daniel17903/PillDispenser/hardware/stl/mechanism/part_1_servo_horn.stl

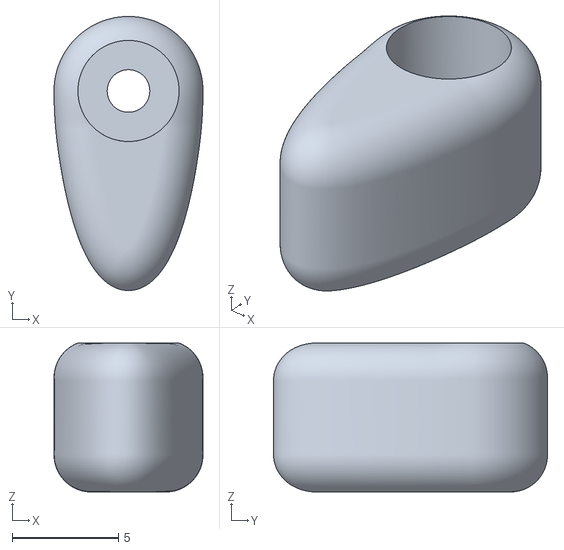
[picture p3: CAD file, 2026-11-14]
hardware/stl/mechanism/part_1_servo_horn.stl
7.00 x 12.9 x 7.00
