daniel17903/PillDispenser/hardware/stl/top.stl

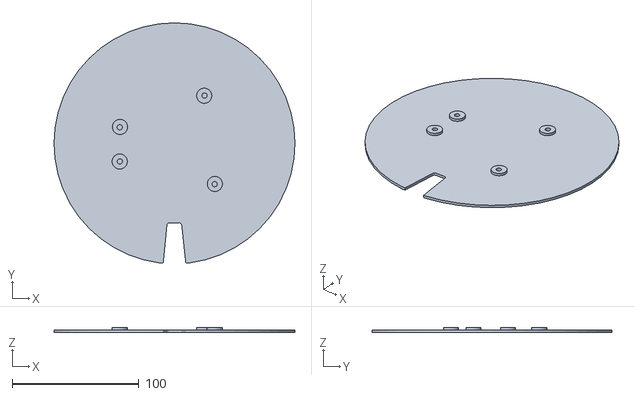
[picture p4: CAD file, 2026-11-07]
hardware/stl/top.stl
190.5 x 189.9 x 4.00
