daniel17903/PillDispenser/hardware/stl/bottom.stl

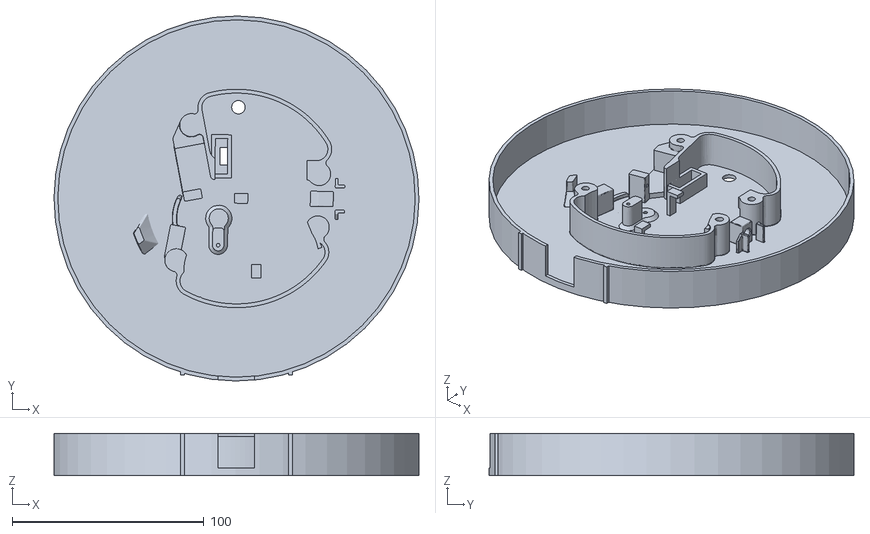
[picture p5: CAD file, 2026-11-07]
hardware/stl/bottom.stl
190.5 x 190.5 x 22.0
