daniel17903/PillDispenser/hardware/stl/mechanism/part_3_pawl.stl

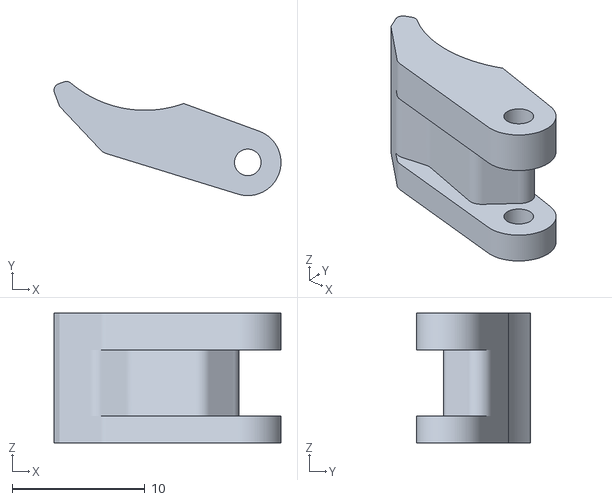
[picture p6: CAD file, 2026-11-07]
hardware/stl/mechanism/part_3_pawl.stl
17.1 x 8.59 x 9.75
