daniel17903/PillDispenser/hardware/stl/foot.stl

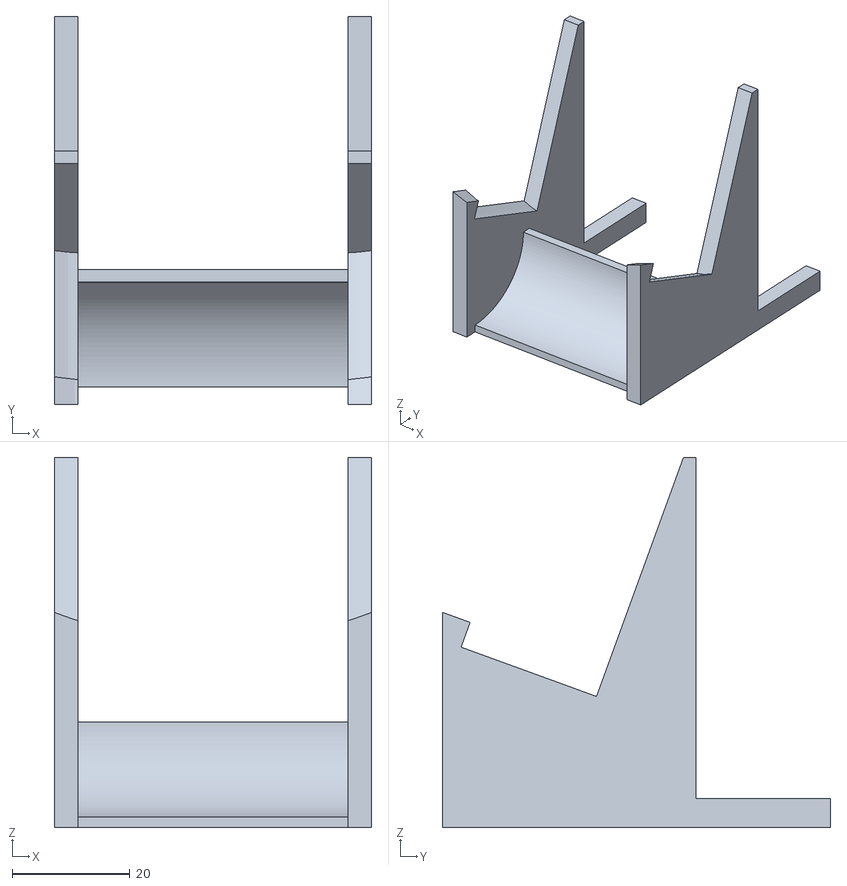
[picture p7: CAD file, 2026-11-07]
hardware/stl/foot.stl
54.0 x 66.0 x 63.0
