daniel17903/PillDispenser/hardware/stl/mechanism/part_4_detent_block.stl

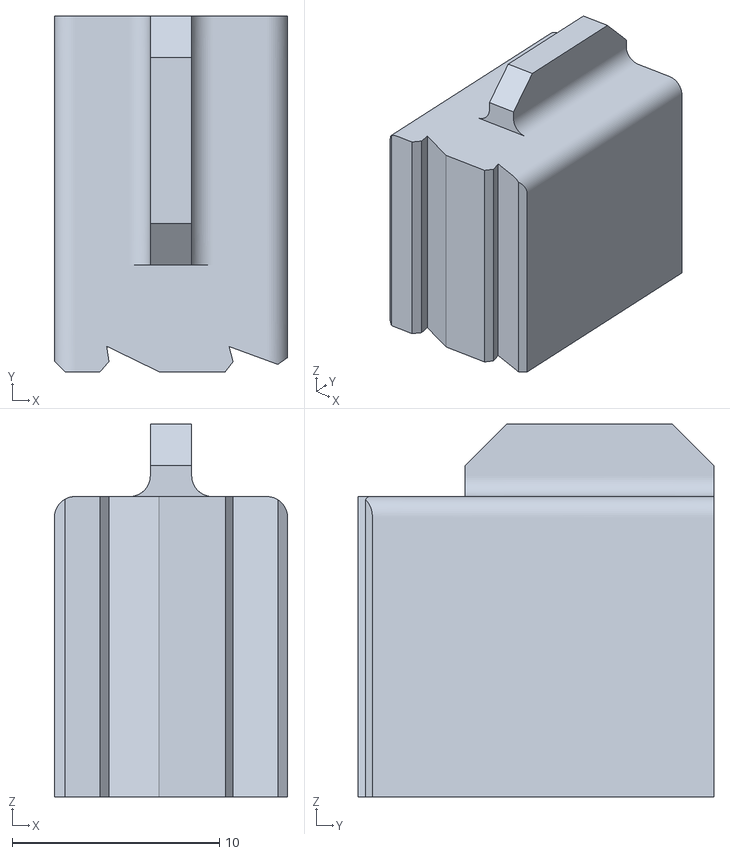
[picture p8: CAD file, 2026-11-07]
hardware/stl/mechanism/part_4_detent_block.stl
11.2 x 17.2 x 18.0
