daniel17903/PillDispenser/hardware/stl/mechanism/part_6_plate.stl

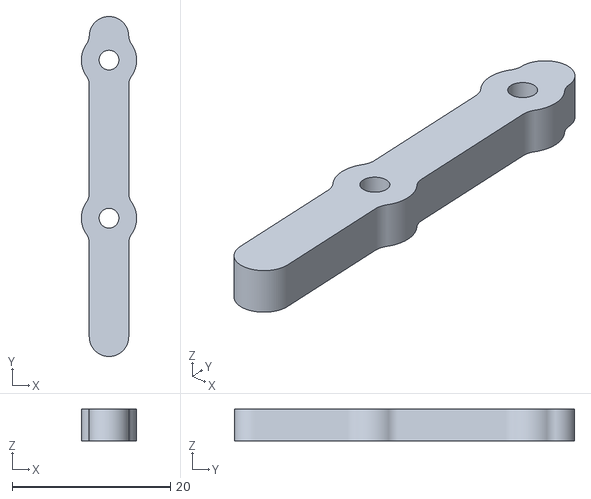
[picture p9: CAD file, 2026-11-07]
hardware/stl/mechanism/part_6_plate.stl
7.00 x 43.0 x 4.00
