daniel17903/PillDispenser/hardware/stl/tray.stl

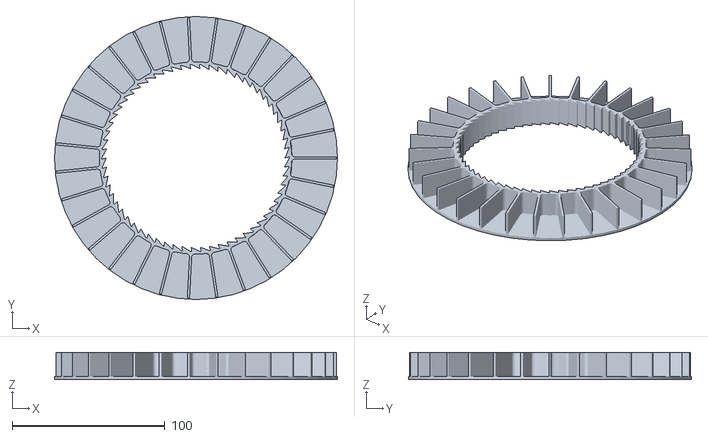
[picture p10: CAD file, 2026-11-07]
hardware/stl/tray.stl
185.5 x 185.5 x 18.0
