daniel17903/PillDispenser/hardware/stl/mechanism/part_5_p10_retainer.stl

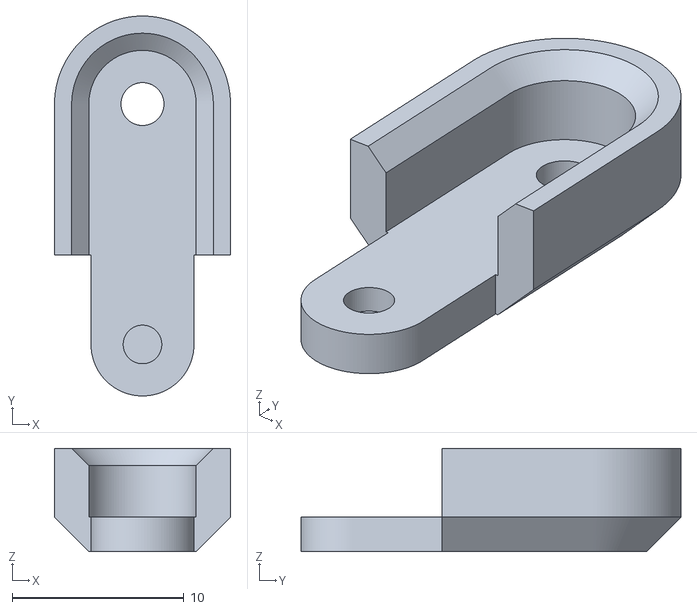
[picture p11: CAD file, 2026-11-07]
hardware/stl/mechanism/part_5_p10_retainer.stl
10.2 x 22.1 x 6.00
