daniel17903/PillDispenser/hardware/stl/mechanism/part_2_lever.stl

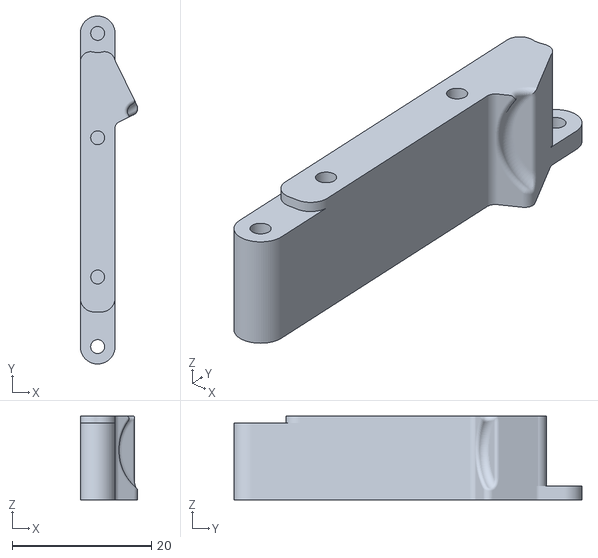
[picture p12: CAD file, 2026-11-07]
hardware/stl/mechanism/part_2_lever.stl
8.26 x 50.0 x 12.0
