daniel17903/PillDispenser/(commit log)

2025-09-25 improve servo range
2026-11-07 cad files
    [A17 - Pill dispenser - Top Dust Cap.stl, A7-A14-A15 - Pill dispenser - Tray Parts.stl, Assembly.stl, Tray_Bottom.stl, Tray_Top.stl, bottom.stl, foot.stl, top.stl]
2026-11-07 Split Assembly.stl into separate part files
    Claude-Session: https://claude.ai/code/session_01SRv9jdJDt94kWemMgPovnc
    [part_1.stl, part_2.stl, part_3.stl, part_4.stl, part_5.stl, part_6.stl]
2026-11-07 Add reinforced part 6 with 4 mm plate thickness
    The original 2 mm plate left only 1.25 mm x 2 mm of material beside each
    screw hole, which cracked in use. The outline, screw holes and bottom
    face are unchanged so it still fits part 2; the ridge is raised with
    the new top surface.
    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
    [part_6_reinforced.stl]
2026-11-07 Make part 6 a flat 4 mm plate and drop the old versions
    Remove the raised nose so the top surface is flat, replace part_6.stl
    with the reinforced part, and delete the separate reinforced file and
    comparison image.
    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
    [part_6.stl, part_6_reinforced.stl]
2026-11-07 Widen part 6 around the screw holes
    Add 7 mm diameter bosses with filleted transitions around both screw
    holes, giving 2.25 mm of wall beside each hole instead of 1.25 mm. The
    rest of the bar stays 5 mm wide.
    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
    [part_6.stl]
2026-11-08 Remove duplicate and superseded CAD files, add exploded view
    Assembly.stl was already split into Assembly_parts/part_1..6 (with an
    updated part_6), and the original Shaztech files (Tray_Bottom, Tray_Top,
    Top Dust Cap, Tray Parts) are superseded by the versions in modified/.
    Claude-Session: https://claude.ai/code/session_01SRv9jZhJbHwKEGwqSJzHod
    [A17 - Pill dispenser - Top Dust Cap.stl, A7-A14-A15 - Pill dispenser - Tray Parts.stl, Assembly.stl, Tray_Bottom.stl, Tray_Top.stl]
2026-11-08 Flatten cad_files/modified, fix foot orientation in exploded view
    Move all files from cad_files/modified one level up, rotate the stand by
    180 degrees in the exploded view and add the script that renders it.
    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
    [bottom.stl, foot.stl, part_1.stl, part_2.stl, part_3.stl, part_4.stl, part_5.stl, part_6.stl]
2026-11-08 Place mechanism parts from photo, add hardware to exploded view
    Fit the camera pose of an assembly photo to the screw posts of
    bottom.stl and match part_1..6 to the photo (part_2/part_6 share the
    screws, part_2 pivots on the floor pin). The exploded view now shows the
    mechanism in place, the ring and lid in separate views, the stand
    upright, and the hardware from Readme.md.
    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
2026-11-08 Exploded view: full bottom, servo, rods, springs and magnets
    Show the whole round bottom, fix the pose of part_3 (pivot on P11 with
    torsion spring P12) and part_5 (holds P10 in the floor pin), move the
    lever spring into its bore, add the spring behind part_4, the SG90
    servo with its two screws and the magnets in bottom and lid. The lid
    is held by magnets, so its screws are no longer drawn.
    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
2026-11-08 Add servo, magnets and torsion spring to the CAD parts list
    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
2026-11-08 Match CAD parts list to the build, drop S2
    The lid is held by magnets, so S2 is not needed. S1 and P9 counts now
    match the exploded view.
    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
2026-11-08 Confirm magnet size in CAD parts list
    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
2026-11-08 List electronics in the CAD parts list
    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
2026-11-08 Add purchase links to the CAD parts list
    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
2026-11-08 Restructure repository for publishing
    - Move sketch to firmware/pill_dispenser, rename config.dist.h to config.example.h
    - Move CAD files to hardware/ (STLs in stl/, descriptive mechanism part names)
    - Exploded view render script resolves paths relative to itself, add requirements.txt
    - Split README into firmware, hardware, Home Assistant and docs pages
    - Add wiring diagram, software sequence/flow diagrams and power consumption doc
    - Add MIT license
    Claude-Session: https://claude.ai/code/session_01SRv9jd7ziyBZaqY1WiB63i
    [bottom.stl, foot.stl, part_1_servo_horn.stl, part_2_lever.stl, part_3_pawl.stl, part_4_detent_block.stl, part_5_p10_retainer.stl, part_6_plate.stl]
2026-11-08 Wiring: confirm servo supply, note that no resistors are used
    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
2026-11-08 Simplify typical-day sequence, add next-alarm automation
    The dispense time can now follow the phone's next alarm (+30 min) via a
    Home Assistant automation using the Companion app's next alarm sensor.
    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
2026-11-14 Make the servo horn (part 1) 1 mm longer
    Stretch the tapered tip of the teardrop by 1 mm (11.87 -> 12.87 mm) with
    a smooth blend below the counterbore. The 2 mm through-hole and the
    4.75 mm x 3 mm counterbore are unchanged.
    [part_1_servo_horn.stl]
2026-11-14 README: a dispense empties one slot, not a single pill
    Each dispense turns the pill ring by one slot and drops everything in
    it, so one dispense can deliver several pills.
